AdamZatloukal/smart-home-hub/hardware/enclosure/podstavec.stp

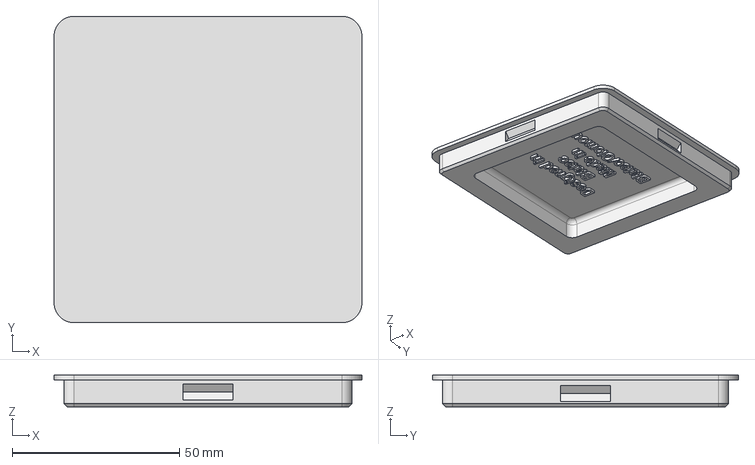
[picture p1: CAD file, 2026-02-24]
hardware/enclosure/podstavec.stp
92.0 x 91.5 x 9.50 mm
