AdamZatloukal/smart-home-hub/hardware/enclosure/base.stp

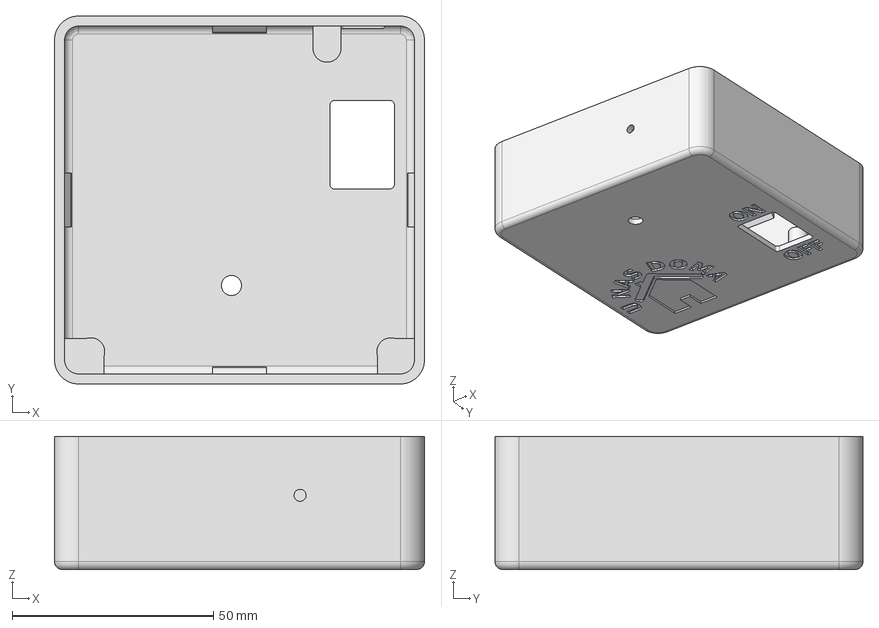
[picture p2: CAD file, 2026-02-24]
hardware/enclosure/base.stp
92.0 x 91.5 x 33.1 mm
