AdamZatloukal/smart-home-hub/hardware/kitchen-pcb.pdf

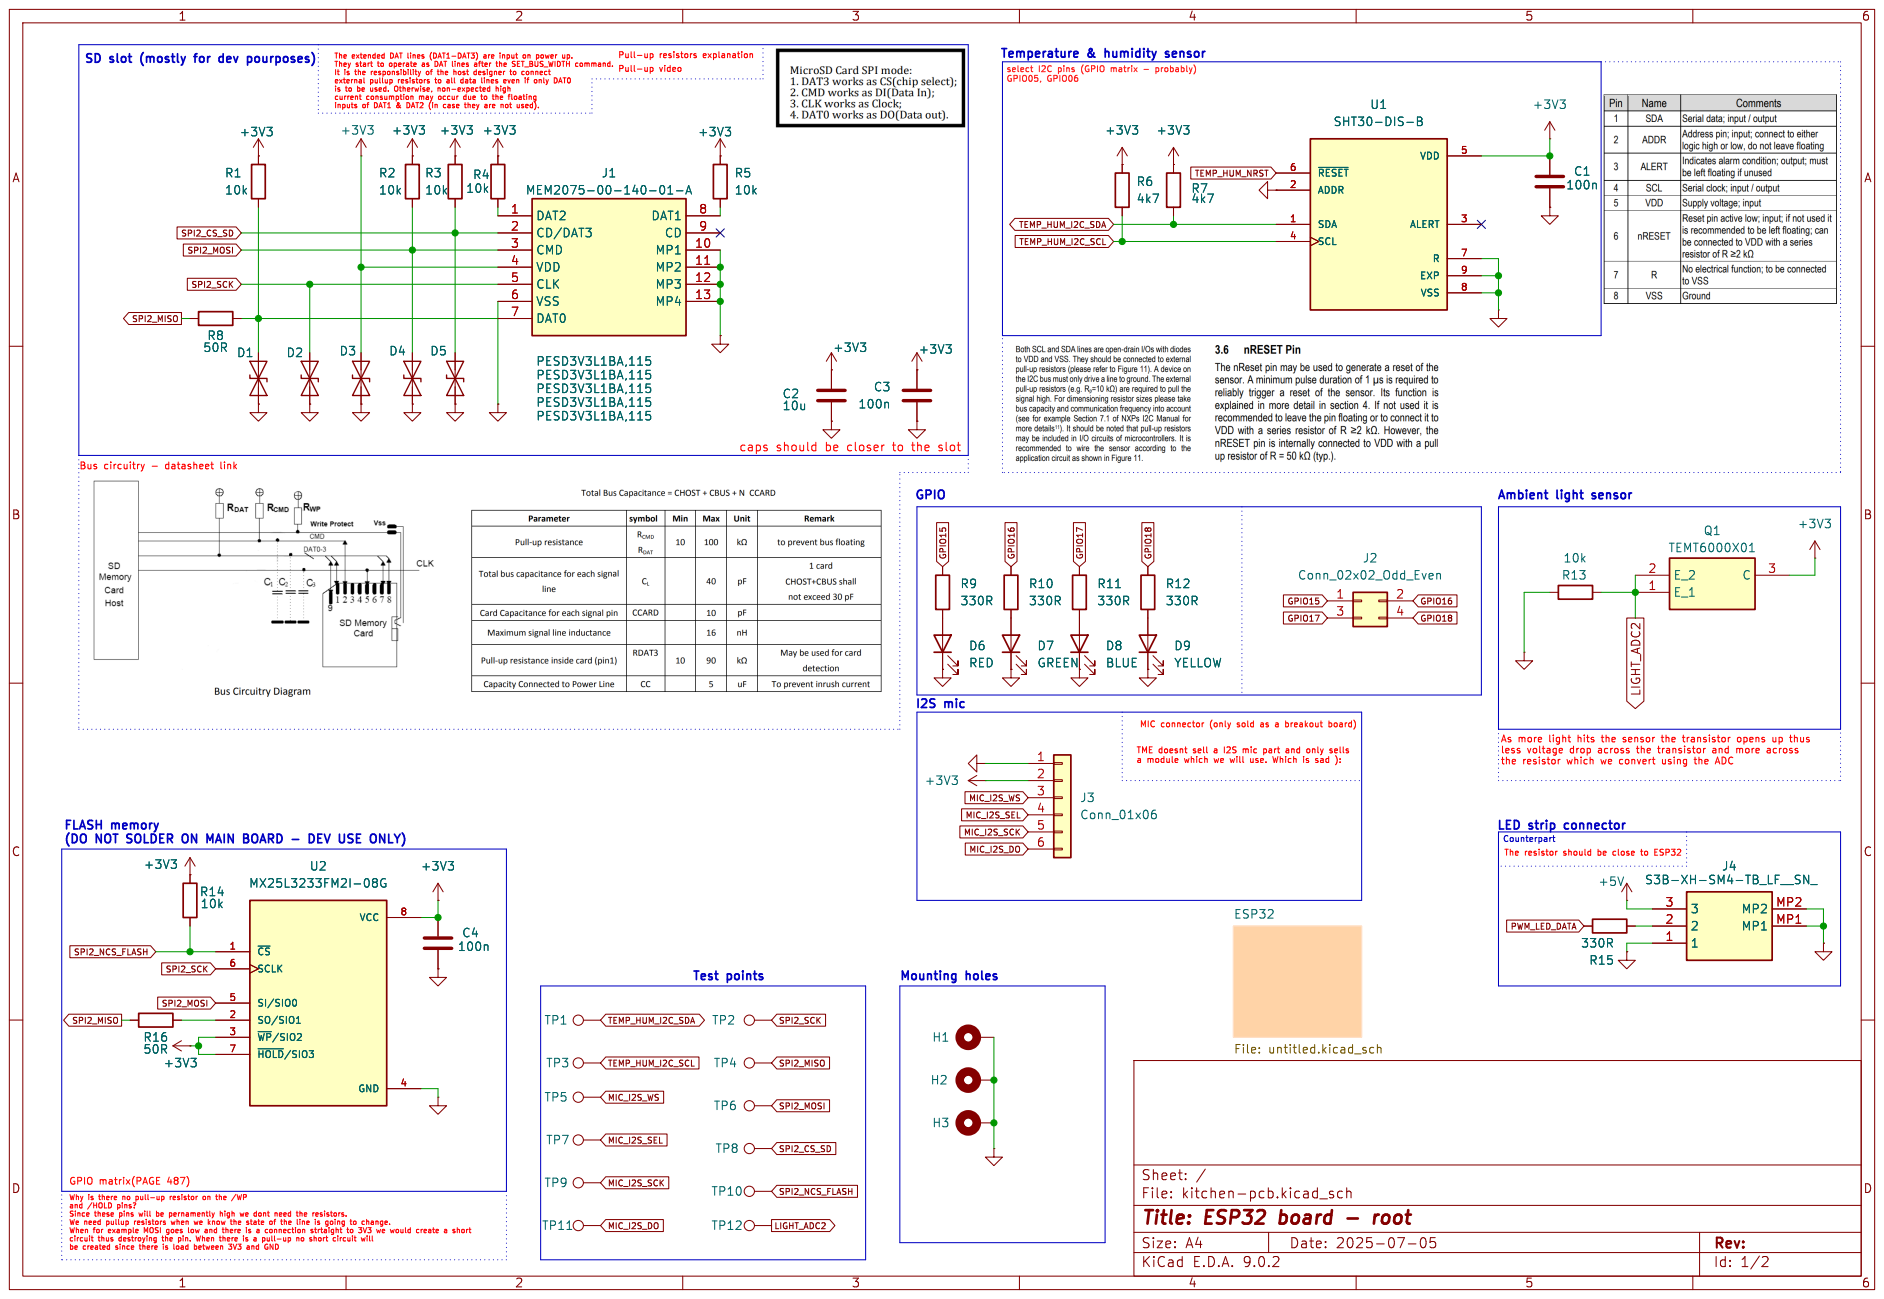
[picture p3: page 1]

(DO NOT SOLDER ON MAIN BOARD - DEV USE ONLY)

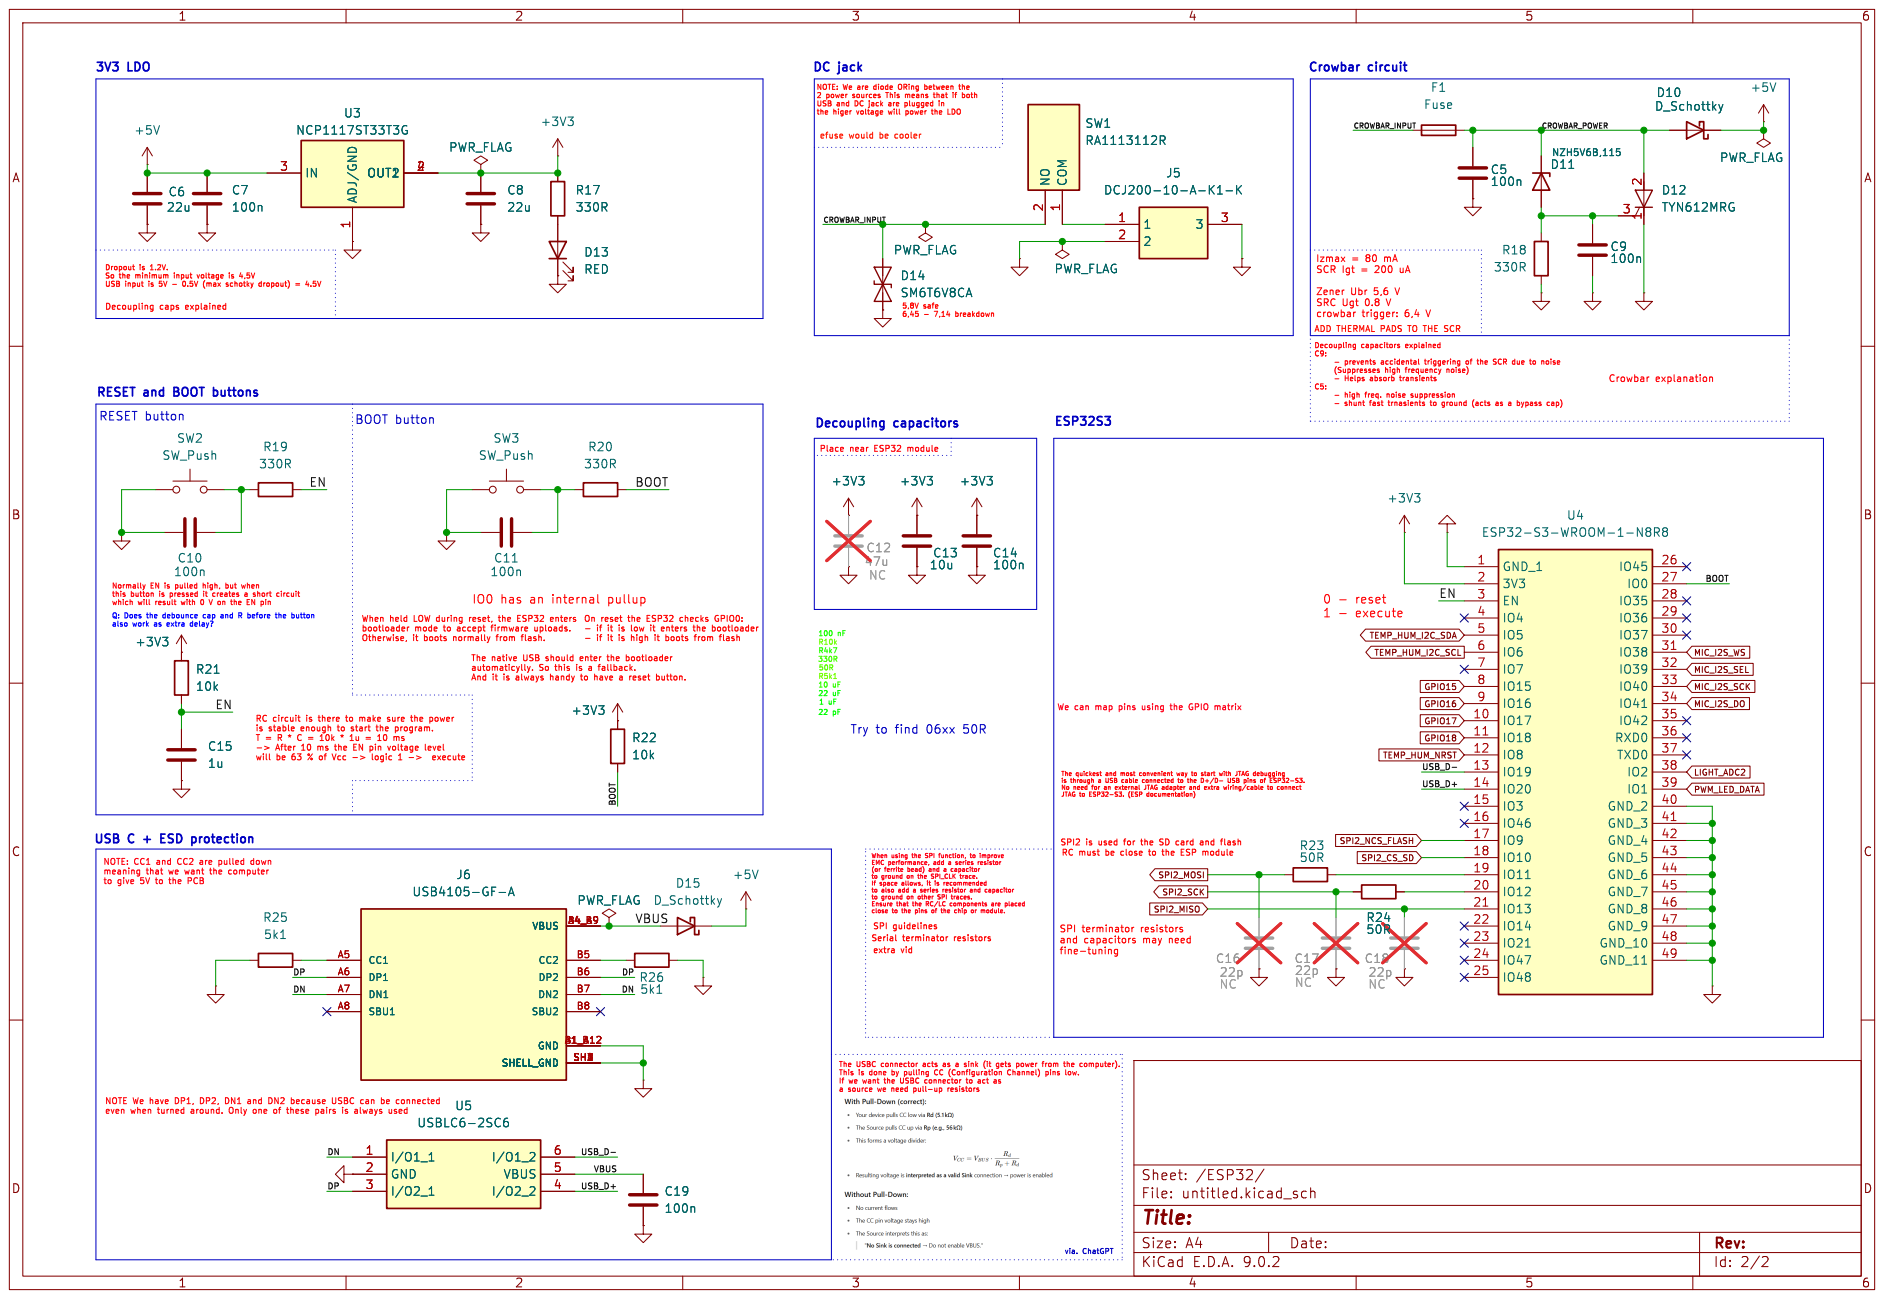
[picture p4: page 2]

ADD THERMAL PADS TO THE SCR DC jack
+3V3 PWR_FLAG

NOTE: We are diode ORing between the

efuse would be cooler

6,45 - 7,14 breakdown On reset the ESP32 checks GPIO0: - if it is low it enters the bootloader

10 uF (https://www.tme.eu/cz/details/cl21a106kaynnne/kondenzatory-mlcc-smd/samsung/) NOTE We have DP1, DP2, DN1 and DN2 because USBC can be connected

fine-tuning We can map pins using the GPIO matrix USB C + ESD protection

is stable enough to start the program. T = R * C = 10k * 1u = 10 ms

SPI2 is used for the SD card and flash

Id: 2/2 Title: File: untitled.kicad_sch Sheet: /ESP32/
