AdamZatloukal/smart-home-hub/hardware/kitchen-pcb.kicad_pcb

## KiCad design hardware/kitchen-pcb.kicad_pcb (2026-02-01)

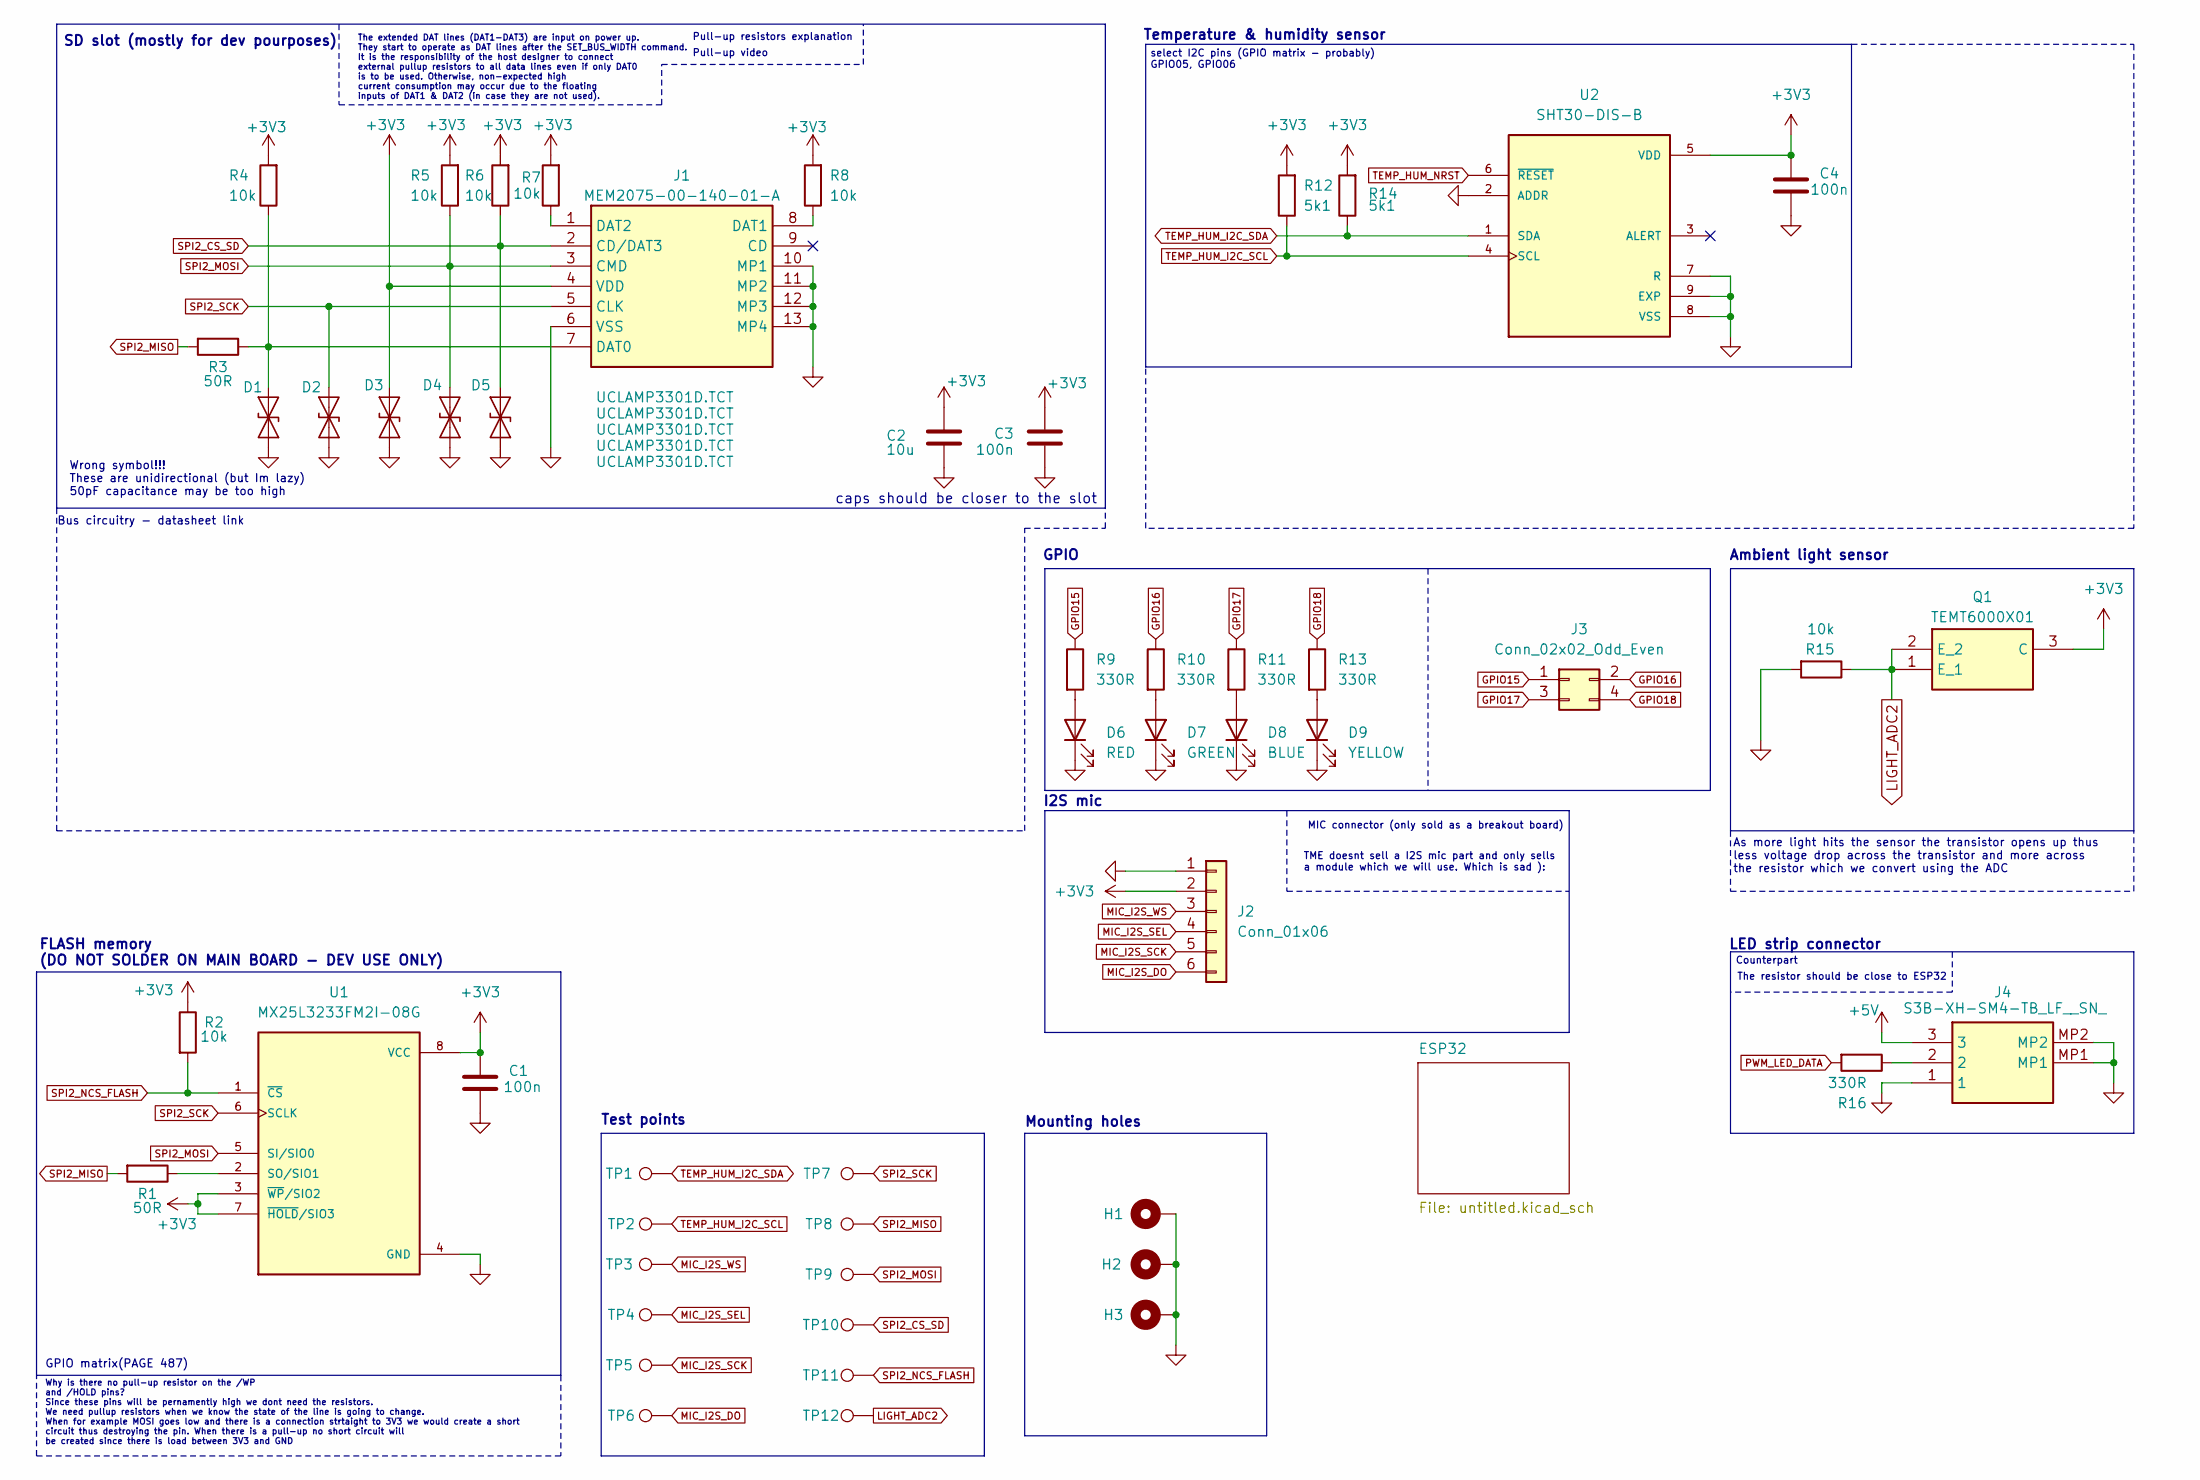
[picture p5: schematic kitchen-pcb.kicad_sch, ESP32 board - root]

Parts:
C1, C3, C4: 100n; C_0805_2012Metric_Pad1.18x1.45mm_HandSolder
C2: 10u; C_0805_2012Metric_Pad1.18x1.45mm_HandSolder
D1, D2, D3, D4, D5: UCLAMP3301D.TCT; SOD2512X110L
D6: RED; LED_0603_1608Metric_Pad1.05x0.95mm_HandSolder
D7: GREEN; LED_0603_1608Metric_Pad1.05x0.95mm_HandSolder
D8: BLUE; LED_0603_1608Metric_Pad1.05x0.95mm_HandSolder
D9: YELLOW; LED_0603_1608Metric_Pad1.05x0.95mm_HandSolder
H1, H2, H3: MountingHole_Pad; MountingHole_3.2mm_M3_DIN965_Pad_TopBottom
J1: MEM2075-00-140-01-A; MEM20750014001A; Manufacturer_Part_Number MEM2075-00-140-01-A
J2: Conn_01x06; mic-module
J3: Conn_02x02_Odd_Even; PinHeader_2x02_P2.54mm_Vertical
J4: S3B-XH-SM4-TB_LF__SN_; S3BXHSM4TBLFSN; Mouser Part Number N/A
Q1: TEMT6000X01; Manufacturer_Part_Number TEMT6000X01
R1, R3: 50R; R_0603_1608Metric_Pad0.98x0.95mm_HandSolder
R2, R4, R5, R6, R7, R8, R15: 10k; R_0805_2012Metric_Pad1.20x1.40mm_HandSolder
R9, R10, R11, R13, R16: 330R; R_0805_2012Metric_Pad1.20x1.40mm_HandSolder
R12, R14: 5k1; R_0805_2012Metric_Pad1.20x1.40mm_HandSolder
TP1, TP3, TP7: Test_SCK; TestPoint_Pad_D1.0mm
TP2, TP4, TP8: Test_MISO; TestPoint_Pad_D1.0mm
TP5, TP9: Test_MOSI; TestPoint_Pad_D1.0mm
TP6, TP10: Test_CS_SD; TestPoint_Pad_D1.0mm
TP11, TP12: Test_NCS_FLASH; TestPoint_Pad_D1.0mm
U1: MX25L3233FM2I-08G; SOIC127P790X216-8N_MX25L3233FM2I-08G; PARTREV 1.6
U2: SHT30-DIS-B; DFN250X250X100-9N

Connections:
+3V3: C1.2, C2.1, C3.1, C4.2, D3.2 (A2), J1.4 (VDD), J2.2, Q1.3 (C), R2.1, R4.2, R5.2, R6.2, R7.2, R8.2, R12.2, R14.2, U1.3 (~WP/SIO2), U1.7 (~HOLD/SIO3), U1.8 (VCC), U2.5 (VDD); also elsewhere on the board
+5V: J4.3; also elsewhere on the board
GND: C1.1, C2.2, C3.2, C4.1, D1.1 (A1), D2.1 (A1), D3.1 (A1), D4.1 (A1), D5.1 (A1), D6.1 (K), D7.1 (K), D8.1 (K), D9.1 (K), H1.1, H2.1, H3.1, J1.6 (VSS), J1.10 (MP1), J1.11 (MP2), J1.12 (MP3), J1.13 (MP4), J2.1, J4.1, J4.MP1, J4.MP2, R15.2, U1.4 (GND), U2.2 (ADDR), U2.7 (R), U2.8 (VSS), U2.9 (EXP); also elsewhere on the board
GPIO15: J3.1, R9.1; also elsewhere on the board
GPIO16: J3.2, R10.1; also elsewhere on the board
GPIO17: J3.3, R11.1; also elsewhere on the board
GPIO18: J3.4, R13.1; also elsewhere on the board
LIGHT_ADC2: Q1.1 (E_1), Q1.2 (E_2), R15.1, TP12.1; also elsewhere on the board
MIC_I2S_DO: J2.6, TP6.1; also elsewhere on the board
MIC_I2S_SCK: J2.5, TP5.1; also elsewhere on the board
MIC_I2S_SEL: J2.4, TP4.1; also elsewhere on the board
MIC_I2S_WS: J2.3, TP3.1; also elsewhere on the board
unnamed: D1.2 (A2), J1.7 (DAT0), R3.1, R4.1
unnamed: D6.2 (A), R9.2
unnamed: D7.2 (A), R10.2
unnamed: D8.2 (A), R11.2
unnamed: D9.2 (A), R13.2
unnamed: J1.8 (DAT1), R8.1
unnamed: J1.1 (DAT2), R7.1
unnamed: J4.2, R16.1
unnamed: R1.1, U1.2 (SO/SIO1)
PWM_LED_DATA: R16.2; also elsewhere on the board
SPI2_CS_SD: D5.2 (A2), J1.2 (CD/DAT3), R6.1, TP10.1; also elsewhere on the board
SPI2_MISO: R1.2, R3.2, TP8.1; also elsewhere on the board
SPI2_MOSI: D4.2 (A2), J1.3 (CMD), R5.1, TP9.1, U1.5 (SI/SIO0); also elsewhere on the board
SPI2_NCS_FLASH: R2.2, TP11.1, U1.1 (~CS); also elsewhere on the board
SPI2_SCK: D2.2 (A2), J1.5 (CLK), TP7.1, U1.6 (SCLK); also elsewhere on the board
TEMP_HUM_I2C_SCL: R12.1, TP2.1, U2.4 (SCL); also elsewhere on the board
TEMP_HUM_I2C_SDA: R14.1, TP1.1, U2.1 (SDA); also elsewhere on the board
TEMP_HUM_NRST: U2.6 (~RESET); also elsewhere on the board

Notes on the sheet:
Pull-up resistors explanation
As more light hits the sensor the transistor opens up thus less voltage drop across the transistor and more across the resistor which we convert using the ADC
Ambient light sensor
Mounting holes
MIC connector (only sold as a breakout board)
Counterpart
caps should be closer to the slot
Bus circuitry - datasheet link
Why is there no pull-up resistor on the /WP and /HOLD pins? Since these pins will be pernamently high we dont need the resistors. We need pullup resistors when we know the state of the line is going to change. When for example MOSI goes low and there is a connection strtaight to 3V3 we would create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
Wrong symbol!!! These are unidirectional (but Im lazy) 50pF capacitance may be too high
GPIO matrix(PAGE 487)
Pull-up video
GPIO
FLASH memory (DO NOT SOLDER ON MAIN BOARD - DEV USE ONLY)
SD slot (mostly for dev pourposes)
LED strip connector
TME doesnt sell a I2S mic part and only sells a module which we will use. Which is sad ):
Test points
The extended DAT lines (DAT1-DAT3) are input on power up. They start to operate as DAT lines after the SET_BUS_WIDTH command. It is the responsibility of the host designer to connect external pullup resistors to all data lines even if only DAT0 is to be used. Otherwise, non-expected high current co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
Temperature & humidity sensor
I2S mic
The resistor should be close to ESP32
select I2C pins (GPIO matrix - probably) GPIO05, GPIO06

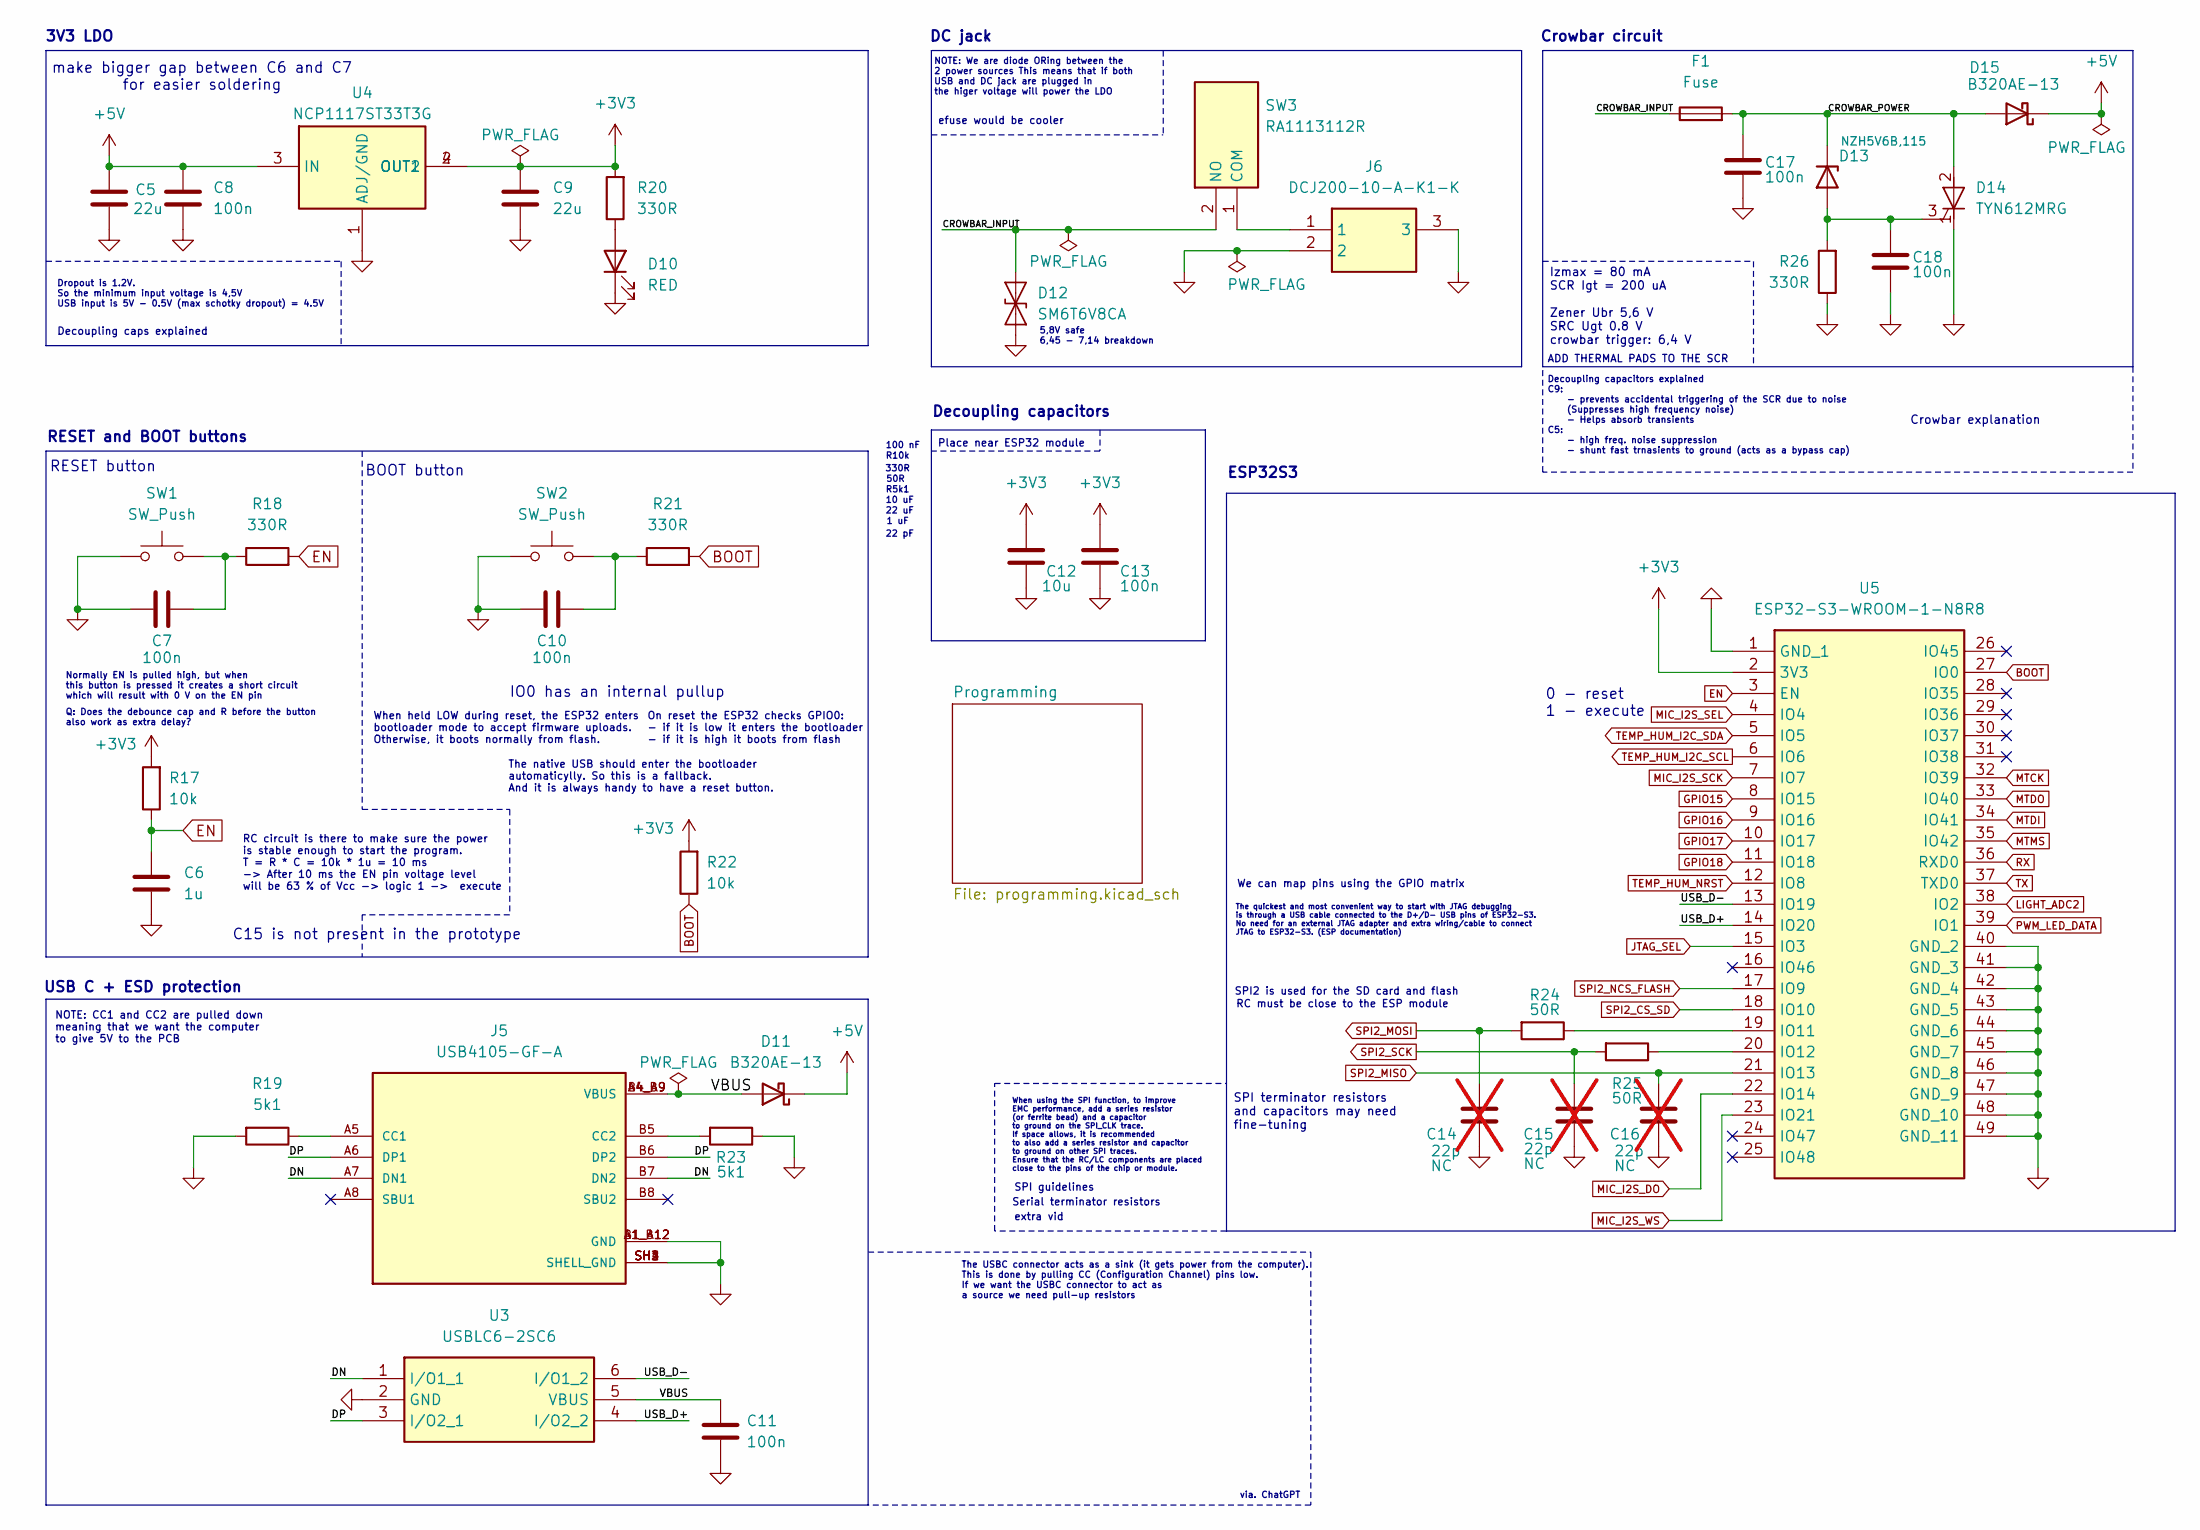
[picture p6: schematic untitled.kicad_sch]

Parts:
C5, C9: 22u; C_0805_2012Metric_Pad1.18x1.45mm_HandSolder
C6: 1u; C_0805_2012Metric_Pad1.18x1.45mm_HandSolder
C7, C8, C10, C11, C13, C17, C18: 100n; C_0805_2012Metric_Pad1.18x1.45mm_HandSolder
C12: 10u; C_0805_2012Metric_Pad1.18x1.45mm_HandSolder
C14, C15, C16: 22p; C_0805_2012Metric_Pad1.18x1.45mm_HandSolder; not fitted
D10: RED; LED_0603_1608Metric_Pad1.05x0.95mm_HandSolder
D11: B320AE-13; DIONM5226X230N
D12: SM6T6V8CA; DIONM5436X265N
D13: NZH5V6B,115; D_SOD-123F
D14: TYN612MRG; TS820600B
D15: B320AE-13; D_SMA
F1: Fuse; FUSC6125X279N
J5: USB4105-GF-A; GCT_USB4105-GF-A; PARTREV B4
J6: DCJ200-10-A-K1-K; BarrelJack_GCT_DCJ200-10-A_Horizontal; Manufacturer_Part_Number DCJ200-10-A-K1-K
R17, R22: 10k; R_0805_2012Metric_Pad1.20x1.40mm_HandSolder
R18, R20, R21, R26: 330R; R_0805_2012Metric_Pad1.20x1.40mm_HandSolder
R19, R23: 5k1; R_0805_2012Metric_Pad1.20x1.40mm_HandSolder
R24, R25: 50R; R_0402_1005Metric_Pad0.72x0.64mm_HandSolder
SW1, SW2: SW_Push; SW_PUSH_6mm_H9.5mm
SW3: RA1113112R; Manufacturer_Part_Number R1966ABLKBLKGR
U3: USBLC6-2SC6; SOT95P280X145-6N; Manufacturer_Part_Number USBLC6-2SC6
U4: NCP1117ST33T3G; SOT230P700X180-4N
U5: ESP32-S3-WROOM-1-N8R8; ESP32S3WROOM1N4; Manufacturer_Part_Number ESP32-S3-WROOM-1-N8R8

Connections:
+3V3: C9.1, C12.1, C13.1, R17.2, R20.2, R22.2, U4.2 (OUT1), U4.4 (OUT2), U5.2 (3V3); also elsewhere on the board
+5V: C5.1, C8.1, D11.1 (K), D15.1 (K), U4.3 (IN); also elsewhere on the board
/ESP32/CROWBAR_INPUT: D12.2 (A2), F1.1, SW3.2 (NO)
/ESP32/CROWBAR_POWER: C17.1, D13.1 (K), D14.2 (A), D15.2 (A), F1.2
/ESP32/DN: J5.A7 (DN1), J5.B7 (DN2), U3.1 (I/O1_1)
/ESP32/DP: J5.A6 (DP1), J5.B6 (DP2), U3.3 (I/O2_1)
/ESP32/USB_D+: U3.4 (I/O2_2), U5.14 (IO20)
/ESP32/USB_D-: U3.6 (I/O1_2), U5.13 (IO19)
/ESP32/VBUS: C11.1, D11.2 (A), J5.A4_B9 (VBUS), J5.B4_A9 (VBUS), U3.5 (VBUS)
BOOT: R21.2, R22.1, U5.27 (IO0); also elsewhere on the board
EN: C6.2, R17.1, R18.2, U5.3 (EN); also elsewhere on the board
GND: C5.2, C6.1, C7.1, C8.2, C9.2, C10.1, C11.2, C12.2, C13.2, C14.1, C15.1, C16.1, C17.2, C18.2, D10.1 (K), D12.1 (A1), D14.1 (K), J5.A1_B12 (GND), J5.B1_A12 (GND), J5.SH1 (SHELL_GND), J5.SH2 (SHELL_GND), J5.SH3 (SHELL_GND), J5.SH4 (SHELL_GND), J6.2, J6.3, R19.2, R23.1, R26.1, SW1.1, SW2.1, U3.2 (GND), U4.1 (ADJ/GND), U5.1 (GND_1), U5.40 (GND_2), U5.41 (GND_3), U5.42 (GND_4), U5.43 (GND_5), U5.44 (GND_6), U5.45 (GND_7), U5.46 (GND_8), U5.47 (GND_9), U5.48 (GND_10), U5.49 (GND_11); also elsewhere on the board
GPIO15: U5.8 (IO15); also elsewhere on the board
GPIO16: U5.9 (IO16); also elsewhere on the board
GPIO17: U5.10 (IO17); also elsewhere on the board
GPIO18: U5.11 (IO18); also elsewhere on the board
JTAG_SEL: U5.15 (IO3); also elsewhere on the board
LIGHT_ADC2: U5.38 (IO2); also elsewhere on the board
MIC_I2S_DO: U5.22 (IO14); also elsewhere on the board
MIC_I2S_SCK: U5.7 (IO7); also elsewhere on the board
MIC_I2S_SEL: U5.4 (IO4); also elsewhere on the board
MIC_I2S_WS: U5.23 (IO21); also elsewhere on the board
MTCK: U5.32 (IO39); also elsewhere on the board
MTDI: U5.34 (IO41); also elsewhere on the board
MTDO: U5.33 (IO40); also elsewhere on the board
MTMS: U5.35 (IO42); also elsewhere on the board
unnamed: C7.2, R18.1, SW1.2
unnamed: C10.2, R21.1, SW2.2
unnamed: D10.2 (A), R20.1
unnamed: C18.1, D13.2 (A), D14.3 (G), R26.2
unnamed: J5.A5 (CC1), R19.1
unnamed: J5.B5 (CC2), R23.2
unnamed: J6.1, SW3.1 (COM)
unnamed: R24.1, U5.19 (IO11)
unnamed: R25.1, U5.20 (IO12)
PWM_LED_DATA: U5.39 (IO1); also elsewhere on the board
RX: U5.36 (RXD0); also elsewhere on the board
SPI2_CS_SD: U5.18 (IO10); also elsewhere on the board
SPI2_MISO: C16.2, U5.21 (IO13); also elsewhere on the board
SPI2_MOSI: C14.2, R24.2; also elsewhere on the board
SPI2_NCS_FLASH: U5.17 (IO9); also elsewhere on the board
SPI2_SCK: C15.2, R25.2; also elsewhere on the board
TEMP_HUM_I2C_SCL: U5.6 (IO6); also elsewhere on the board
TEMP_HUM_I2C_SDA: U5.5 (IO5); also elsewhere on the board
TEMP_HUM_NRST: U5.12 (IO8); also elsewhere on the board
TX: U5.37 (TXD0); also elsewhere on the board

Notes on the sheet:
330R
Q: Does the debounce cap and R before the button also work as extra delay?
DC jack
USB C + ESD protection
3V3 LDO
NOTE: CC1 and CC2 are pulled down meaning that we want the computer to give 5V to the PCB
Crowbar explanation
Serial terminator resistors
R5k1
22 uF
Decoupling capacitors explained C9: - prevents accidental triggering of the SCR due to noise (Suppresses high frequency noise) - Helps absorb transients C5: - high freq. noise suppression - shunt fast trnasients to ground (acts as a bypass cap)
R10k
SPI terminator resistors and capacitors may need fine-tuning
We can map pins using the GPIO matrix
0 - reset 1 - execute
ADD THERMAL PADS TO THE SCR
100 nF
RESET button
When held LOW during reset, the ESP32 enters bootloader mode to accept firmware uploads. Otherwise, it boots normally from flash.
SPI guidelines
IO0 has an internal pullup
make bigger gap between C6 and C7 for easier soldering
The USBC connector acts as a sink (it gets power from the computer). This is done by pulling CC (Configuration Channel) pins low. If we want the USBC connector to act as a source we need pull-up resistors
Decoupling caps explained
Izmax = 80 mA SCR Igt = 200 uA Zener Ubr 5,6 V SRC Ugt 0.8 V crowbar trigger: 6,4 V
Place near ESP32 module
50R
The quickest and most convenient way to start with JTAG debugging is through a USB cable connected to the D+/D- USB pins of ESP32-S3. No need for an external JTAG adapter and extra wiring/cable to connect JTAG to ESP32-S3. (ESP documentation)
extra vid
Crowbar circuit
efuse would be cooler
Dropout is 1.2V. So the minimum input voltage is 4,5V USB input is 5V - 0.5V (max schotky dropout) = 4.5V
RESET and BOOT buttons
22 pF
10 uF
via. ChatGPT
SPI2 is used for the SD card and flash
Decoupling capacitors
RC circuit is there to make sure the power is stable enough to start the program. T = R * C = 10k * 1u = 10 ms -> After 10 ms the EN pin voltage level will be 63 % of Vcc -> logic 1 -> execute
5,8V safe 6,45 - 7,14 breakdown
BOOT button
RC must be close to the ESP module
NOTE: We are diode ORing between the 2 power sources This means that if both USB and DC jack are plugged in the higer voltage will power the LDO
Normally EN is pulled high, but when this button is pressed it creates a short circuit which will result with 0 V on the EN pin
C15 is not present in the prototype
1 uF
On reset the ESP32 checks GPIO0: - if it is low it enters the bootloader - if it is high it boots from flash
When using the SPI function, to improve EMC performance, add a series resistor (or ferrite bead) and a capacitor to ground on the SPI_CLK trace. If space allows, it is recommended to also add a series resistor and capacitor to ground on other SPI traces. Ensure that the RC/LC components are placed 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
The native USB should enter the bootloader automaticylly. So this is a fallback. And it is always handy to have a reset button.
ESP32S3

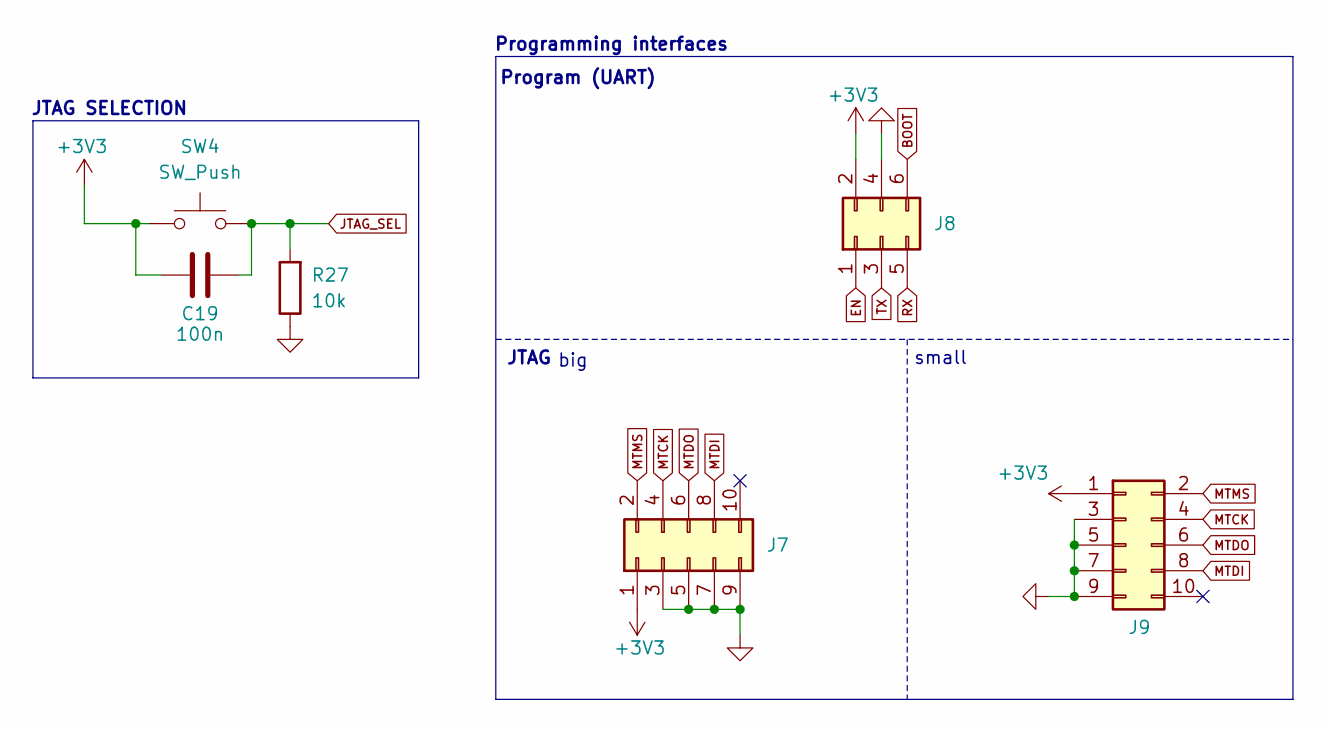
[picture p7: schematic programming.kicad_sch]

Parts:
C19: 100n; C_0805_2012Metric_Pad1.18x1.45mm_HandSolder
J7: Conn_02x05_Odd_Even; PinHeader_2x05_P2.54mm_Vertical
J8: Conn_02x03_Odd_Even; PinHeader_2x03_P2.54mm_Vertical
J9: Conn_02x05_Odd_Even; FTSH10501LDVK
R27: 10k; R_0805_2012Metric_Pad1.20x1.40mm_HandSolder
SW4: SW_Push; SW_PUSH_6mm_H9.5mm

Connections:
+3V3: C19.1, J7.1, J8.2, J9.1, SW4.1; also elsewhere on the board
BOOT: J8.6; also elsewhere on the board
EN: J8.1; also elsewhere on the board
GND: J7.3, J7.5, J7.7, J7.9, J8.4, J9.3, J9.5, J9.7, J9.9, R27.1; also elsewhere on the board
JTAG_SEL: C19.2, R27.2, SW4.2; also elsewhere on the board
MTCK: J7.4, J9.4; also elsewhere on the board
MTDI: J7.8, J9.8; also elsewhere on the board
MTDO: J7.6, J9.6; also elsewhere on the board
MTMS: J7.2, J9.2; also elsewhere on the board
RX: J8.5; also elsewhere on the board
TX: J8.3; also elsewhere on the board

Notes on the sheet:
JTAG
big
Programming interfaces
Program (UART)
small
JTAG SELECTION

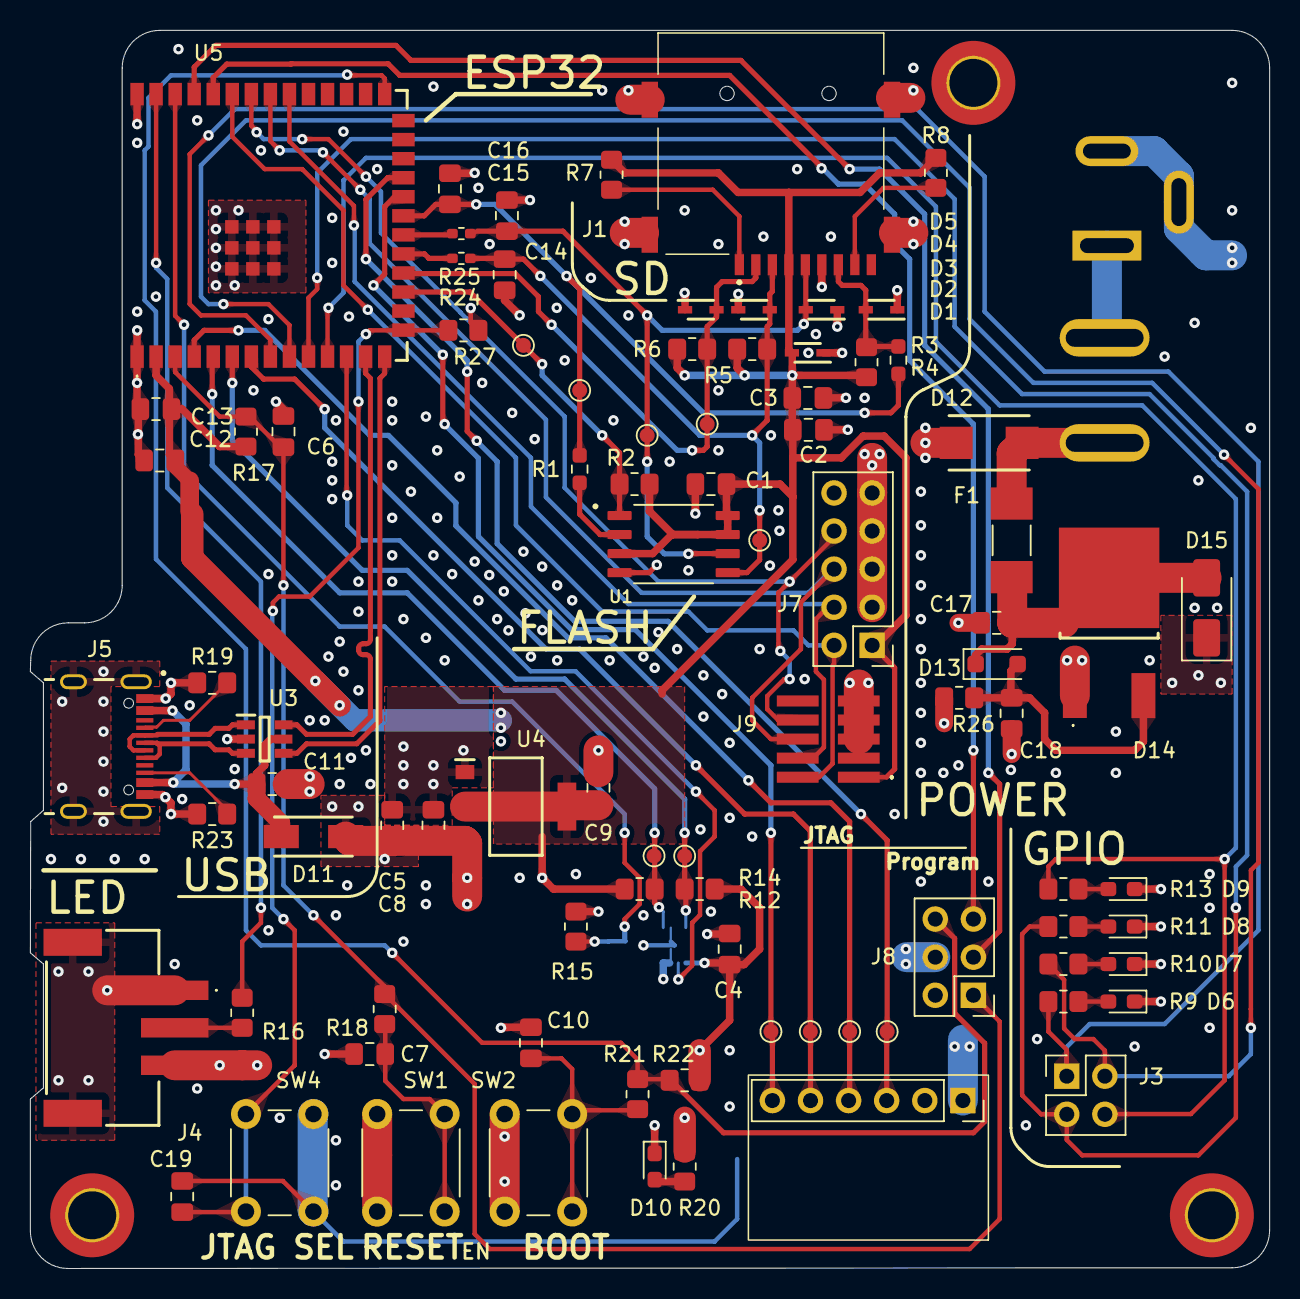
[picture p8: board kitchen-pcb.kicad_pcb from above]

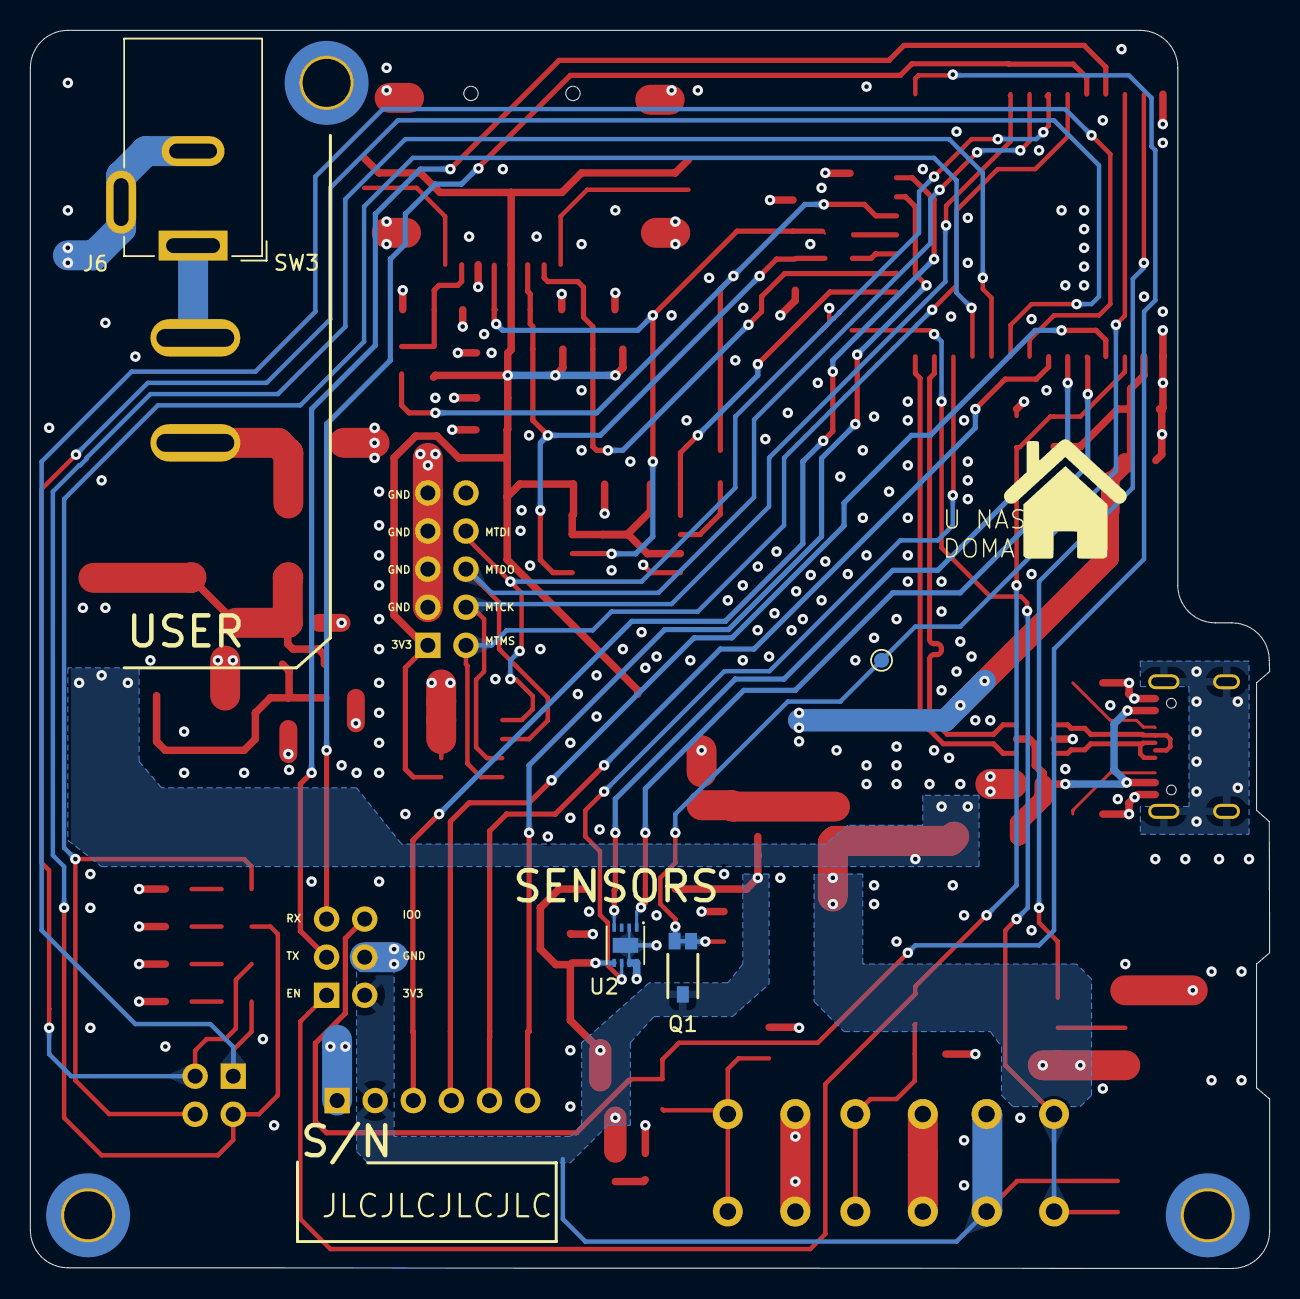
[picture p9: board kitchen-pcb.kicad_pcb from below]

Board: 4 copper layers, 82.6 x 82.5 mm, 96 parts (5 on the bottom side), 55 nets.
