AdamZatloukal/smart-home-hub/firmware/main/src/wifi.c

#include "freertos/FreeRTOS.h"
#include "wifi.h"
#include <stdio.h>
#include "esp_wifi.h"
#include "nvs.h"
#include "nvs_flash.h"
#include "esp_log.h"
#include "esp_event.h"
#include "esp_netif.h"
#include "freertos/task.h"
#include "freertos/event_groups.h"


#include "esp_http_server.h"
#include "driver/gpio.h"
#include "cJSON.h"
#include "sys/param.h"
#include "led.h"

static const char* TAG = "WIFI";

/*
* arg is user data passed in the handler
* event_base is the category of the event (selected in event_register) - IP_EVENT
* event_id is the specific event id - IP_EVENT_STA_GOT_IP
* event_data is the infromation from the event
* void* means a pointer to any type - generic pointer
*       we cannot directly dereference it and need to cast it to the correct type
*/
static void got_ip_handler(void *arg, esp_event_base_t event_base, int32_t event_id, void *event_data) {
    ip_event_got_ip_t *event = (ip_event_got_ip_t *) event_data;
    ESP_LOGI(TAG, "Got IP: " IPSTR, IP2STR(&event->ip_info.ip));

    retry_num = 0; 
    xEventGroupSetBits(wifi_event_group, WIFI_SUCCESS);
}

static void wifi_event_handler(void *arg, esp_event_base_t event_base, int32_t event_id, void *event_data) {
    esp_err_t status_connect;
    /* if the event is that the ESP32 was configured as a station it means we can connect to the AP*/
    if (event_id == WIFI_EVENT_STA_START) {
        ESP_LOGI(TAG, "Connecting to AP...");

        status_connect = esp_wifi_connect(); // tries to connect to the AP
    
        ESP_LOGI("WIFI", "esp_wifi_connect status: %s", esp_err_to_name(status_connect));
    }
    else if (event_id == WIFI_EVENT_STA_DISCONNECTED) {
        if (retry_num < MAX_FAILURES) {
            ESP_LOGI(TAG, "Connecting to AP...");

            status_connect = esp_wifi_connect();
            retry_num++;
        }
        else {
            xEventGroupSetBits(wifi_event_group, WIFI_FAILURE);
        }
    }
}

esp_err_t connect_wifi() {
    int status = WIFI_FAILURE;

    /* network interface init*/
    esp_netif_init(); // initializes the TCP/IP stack
    esp_event_loop_create_default(); // creates an event loop so that we can handle events
    esp_netif_create_default_wifi_sta(); // create the interface for wifi station - like a door between our code and the wifi driver

    /* look in the docs for these functions - AI told me to add them*/
    esp_event_handler_instance_t got_ip_event_handler_instance;
    esp_event_handler_instance_register(IP_EVENT, // type of event we want to register
                                        IP_EVENT_STA_GOT_IP, // specific type of ip event
                                        &got_ip_handler, // call this function what IP_EVENT_STA_GOT_IP happens
                                         NULL, // data that will be passed as arg to the on_got_ip function
                                         &got_ip_event_handler_instance); // handler instance - needed for when we want to unregister the event

    esp_event_handler_instance_t wifi_handler_event_instance;
    esp_event_handler_instance_register(WIFI_EVENT,
                                        ESP_EVENT_ANY_ID,
                                        &wifi_event_handler,
                                        NULL,
                                        &wifi_handler_event_instance);

    wifi_init_config_t config = WIFI_INIT_CONFIG_DEFAULT(); // creates a struct with wifi init information

    esp_wifi_init(&config); // prepares and powers up the WiFi system on the ESP32. It allocates memory, loads data and starts a RTOS task.
    esp_wifi_set_mode(WIFI_MODE_STA); // set the mode of the ESP as station

    wifi_event_group = xEventGroupCreate();

    wifi_config_t wifi_config = { // set the configuration for the network we want to connect to
        .sta = {
            .ssid = "Unasdoma",
            .password = "delfin13"
        }
    };

    esp_wifi_set_config(WIFI_IF_STA, &wifi_config); // configures wifi settings like the ssid and password
    esp_wifi_start(); // enables the HW required for WiFi - events will start to happen

    // blocks the execution of the function until the condition is true
    EventBits_t bits = xEventGroupWaitBits(wifi_event_group, 
                                        WIFI_FAILURE | WIFI_SUCCESS, // 0010 | 0001 -> 0011 (0x03) - the code will continue to execute when this is true - this adds the two bits into a mask
                                        pdFALSE, // the bits we are waiting for will not be cleared
                                        pdFALSE, // wait stops when any one of the bits is set
                                        portMAX_DELAY); // block indefinitely

    /* check for what event actually happened */
    if (bits & WIFI_SUCCESS) { // 0001 (WIFI_SUCCESS) & 0001 -> 0001 (true) 
        status = WIFI_SUCCESS; // 0010 (WIFI_FAILURE) & 0001 -> 0000 (false)
        ESP_LOGI(TAG, "Connected to AP");
    }
    else if (bits & WIFI_FAILURE) { 
        status = WIFI_FAILURE;
        ESP_LOGI(TAG, "Failed to connect to the AP");
    }
    else {
        ESP_LOGI(TAG, "Unexpected event");
        status = WIFI_FAILURE;
    }

    /* unregister the events after they are not needed */
    esp_event_handler_instance_unregister(WIFI_EVENT, ESP_EVENT_ANY_ID, wifi_handler_event_instance);
    esp_event_handler_instance_unregister(IP_EVENT, IP_EVENT_STA_GOT_IP, got_ip_event_handler_instance);
    vEventGroupDelete(wifi_event_group);

    return status;
}

esp_err_t led_on_handler(httpd_req_t* req) {
    const char *respone = "LED ON";

    led_strip_handle_t led_strip = configure_strip();
    ESP_ERROR_CHECK(led_strip_set_pixel(led_strip, 0, 255, 0, 0));
    ESP_ERROR_CHECK(led_strip_refresh(led_strip));

    ESP_LOGI("HTTP", "LED ON");
    httpd_resp_send(req, respone, HTTPD_RESP_USE_STRLEN);
    return ESP_OK;
}

esp_err_t led_off_handler(httpd_req_t* req) {
    const char *response = "LED OFF";
    
    gpio_set_level(LED_PIN, 0);
    ESP_LOGI("HTTP", "LED OFF");
    httpd_resp_send(req, response, HTTPD_RESP_USE_STRLEN);
    return ESP_OK;
}

esp_err_t data_colors_handler(httpd_req_t *req) {
    char content[100]; // buffer for the recieved data
    
    /* if the amount of data we received is larger than the buffer we
     will cutoff the amount of dara we received to the size of the buffer */
    size_t recv_size = MIN(req->content_len, sizeof(content));

    int ret = httpd_req_recv(req, content, recv_size); // get the data

    if (ret <= 0) { // 0 return value indicates closed connection

        if (ret == HTTPD_SOCK_ERR_TIMEOUT) {
            // ADD: try to reconnect
            httpd_resp_send_408(req);
        }
        return ESP_FAIL;
    }

    const char *response = "DATA RECEIVED";
    httpd_resp_send(req, response, HTTPD_RESP_USE_STRLEN);

    const cJSON *colors;

    colors = cJSON_Parse((const char *)content);
    const cJSON *red = cJSON_GetObjectItem(colors, "red");
    const cJSON *green = cJSON_GetObjectItem(colors, "green");
    const cJSON *blue = cJSON_GetObjectItem(colors, "blue");

    ESP_LOGI("COLORS", "RED: %d    GREEN: %d   BLUE: %d", red->valueint, green->valueint, blue->valueint);
    return ESP_OK;
}

httpd_handle_t start_webserver() {
    httpd_config_t config = HTTPD_DEFAULT_CONFIG();

    httpd_handle_t server_handle = NULL;

    /*
    * GET mean the server (ESP) is sending data to us
    * POST means that we are sending the data to the server
    */
    httpd_uri_t led_on = {
        .uri = "/led/on",
        .method = HTTP_GET,
        .handler = led_on_handler
    };

    httpd_uri_t led_off = {
        .uri = "/led/off",
        .method = HTTP_GET,
        .handler = led_off_handler
    };

    httpd_uri_t data_colors = {
        .uri = "/data/colors",
        .method = HTTP_POST,
        .handler = data_colors_handler,
    };

    if (httpd_start(&server_handle, &config) == ESP_OK) {
        ESP_ERROR_CHECK(httpd_register_uri_handler(server_handle, &led_on));
        ESP_ERROR_CHECK(httpd_register_uri_handler(server_handle, &led_off));
        ESP_ERROR_CHECK(httpd_register_uri_handler(server_handle, &data_colors));
    }

    return server_handle;

}
