AdamZatloukal/smart-home-hub/(commit log)

2025-07-22 Layout v0.2
    [kitchen-pcb.kicad_pcb]
2025-07-23 Schematics adjustments - updated some components
    [kitchen-pcb.kicad_pcb, untitled.kicad_sch]
2025-07-26 Added notes to schematics, SPI modifications
    [kitchen-pcb.kicad_pcb, kitchen-pcb.kicad_sch, untitled.kicad_sch]
2025-07-27 Layout v0,4
    [kitchen-pcb.kicad_pcb, kitchen-pcb.kicad_sch, untitled.kicad_sch]
2025-07-27 Layout v0.5
    [kitchen-pcb.kicad_pcb]
2025-07-28 Changed to microSD, layout v0.6.1
    [kitchen-pcb.kicad_pcb, kitchen-pcb.kicad_sch, untitled.kicad_sch]
2025-07-29 Layout v0.6.2, SW1 footprint
    [kitchen-pcb.kicad_pcb, kitchen-pcb.kicad_sch]
2025-07-30 SD card routing v0.1
    [kitchen-pcb.kicad_pcb, untitled.kicad_sch]
2025-07-30 FLASH routing
    [kitchen-pcb.kicad_pcb]
2025-07-31 Error, warning free routing v0.1 (no silkscreen)
    [kitchen-pcb.kicad_pcb, kitchen-pcb.kicad_sch]
2025-08-01 DFM ready PCB no silkscreen
    [bom.csv, designators.csv, positions.csv]
2025-08-02 Added silkscreen
    [designators.csv, kitchen-pcb.kicad_pcb]
2025-08-03 Production ready v0.1
    [kitchen-pcb.kicad_pcb]
2025-08-03 Track & via free board ready for routing
    [kitchen-pcb.kicad_pcb]
2025-08-03 PCB v0.2 (Changed GPIO routing, better power distribution)
    [kitchen-pcb.kicad_pcb]
2025-08-04 v0.3.1 Changed board stackup and impedance controlled traces
    [bom.csv, designators.csv, kitchen-pcb.kicad_pcb, kitchen-pcb.kicad_sch, untitled.kicad_sch]
2025-08-05 v0.4 - ORDERED
    [bom.csv, kitchen-pcb.kicad_pcb, positions.csv]
2026-01-21 Working prototype, PCB prototype revision done
    [bom.csv, kitchen-pcb.kicad_pcb, kitchen-pcb.kicad_sch, untitled.kicad_sch]
2026-01-21 pcb file is broken
    [kitchen-pcb.kicad_sch, untitled.kicad_sch]
2026-01-21 fixed pcb file
    [kitchen-pcb.kicad_pcb]
2026-01-21 rought first draft - silkscrren, crossover problems, modify for easier soldering
    [kitchen-pcb.kicad_pcb]
2026-01-21 Tried to prevent crosstalk, fixed silkscreen, changes to fit DFM
    [bom.csv, designators.csv, kitchen-pcb.kicad_sch, positions.csv, programming.kicad_sch, untitled.kicad_sch]
2026-01-21 minor tweaks - sent to production
    [kitchen-pcb.kicad_pcb, untitled.kicad_sch]
2026-02-01 fixing merge conflicts
    [kitchen-pcb.kicad_sch, untitled.kicad_sch]
